cmumford/cmumford-components/src/ESP32_WROVER.FCStd

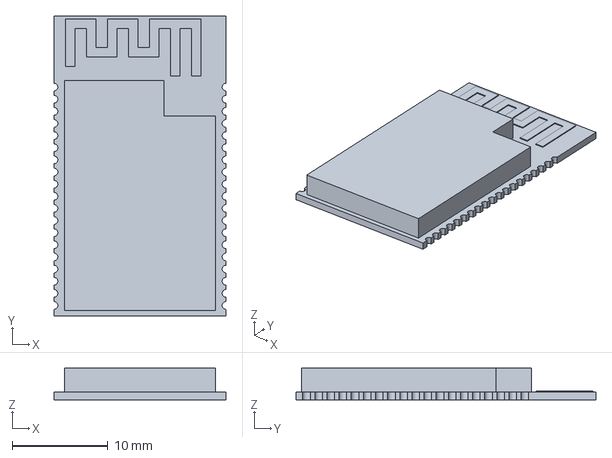
[picture p1: CAD file, 2022-02-04]
src/ESP32_WROVER.FCStd
18.0 x 31.4 x 3.30 mm
