cmumford/cmumford-components/3dshapes/PTS810SJS250SMTR LFS.STEP

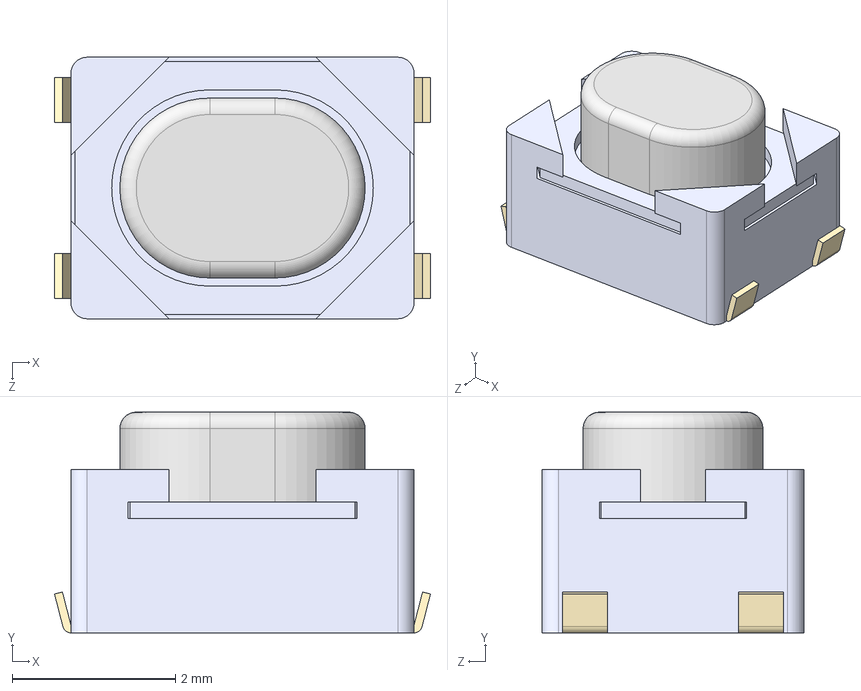
[picture p2: CAD file, 2026-04-09]
3dshapes/PTS810SJS250SMTR LFS.STEP
4.60 x 2.70 x 3.20 mm
