cmumford/cmumford-components/3dshapes/PEC12R-4225F-S0024.step

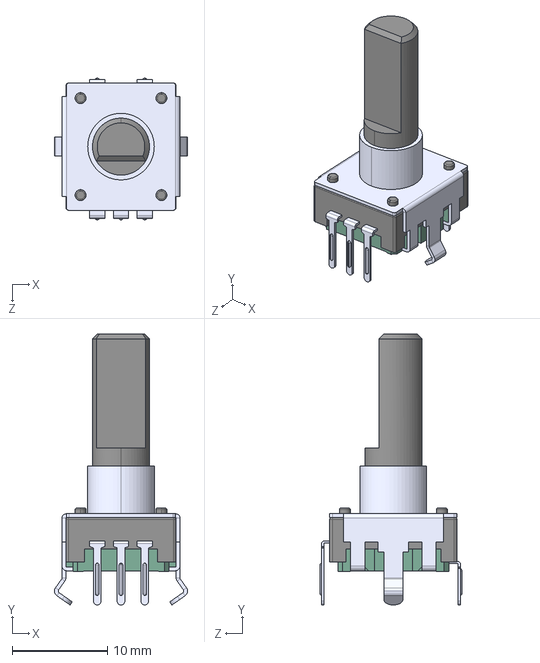
[picture p3: CAD file, 2026-04-09]
3dshapes/PEC12R-4225F-S0024.step
14.0 x 28.5 x 14.9 mm
