cmumford/cmumford-components/3dshapes/ABS07L-32.768KHZ-T.step

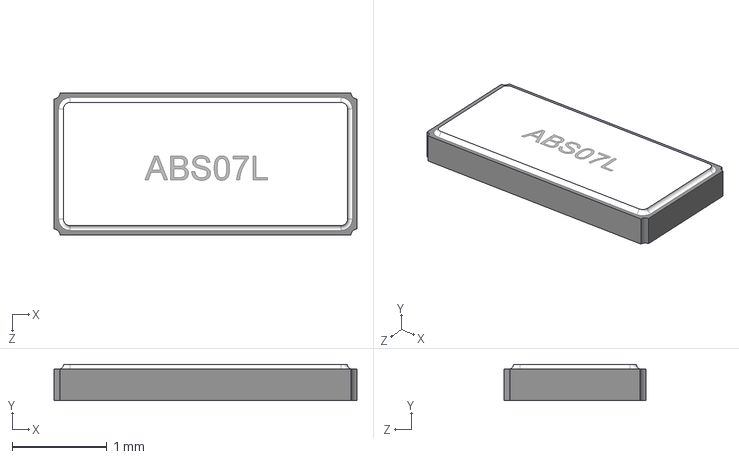
[picture p4: CAD file, 2026-04-09]
3dshapes/ABS07L-32.768KHZ-T.step
3.20 x 0.383 x 1.50 mm
