cmumford/cmumford-components/3dshapes/PTN16-A10120K1A2.step

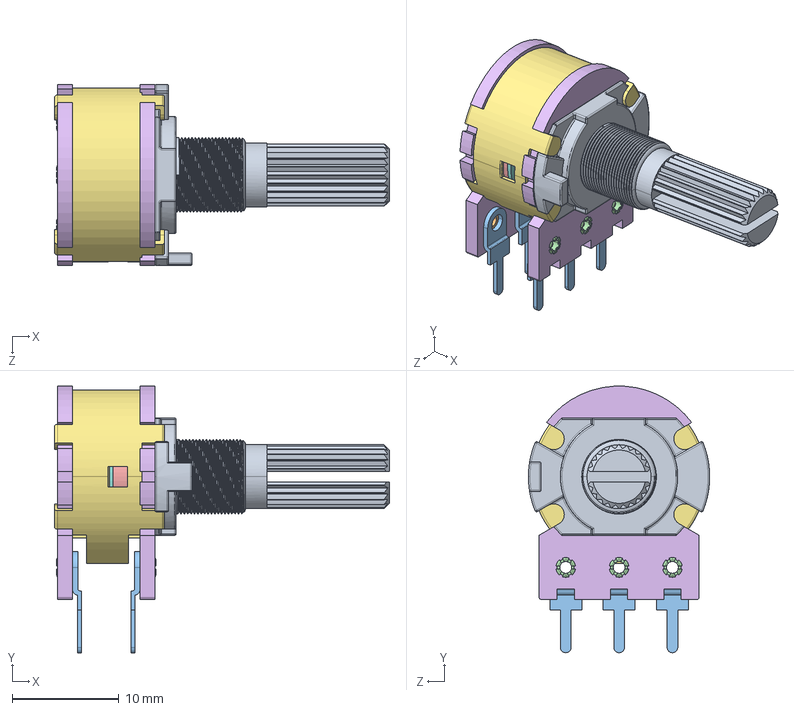
[picture p5: CAD file, 2026-04-08]
3dshapes/PTN16-A10120K1A2.step
31.4 x 25.0 x 17.0 mm
PTN16_2 BUSHING
PTN16-A_2 HOUSING
PTN16_20K1_SHAFT
