cmumford/cmumford-components/3dshapes/SJ1-3534NG.step

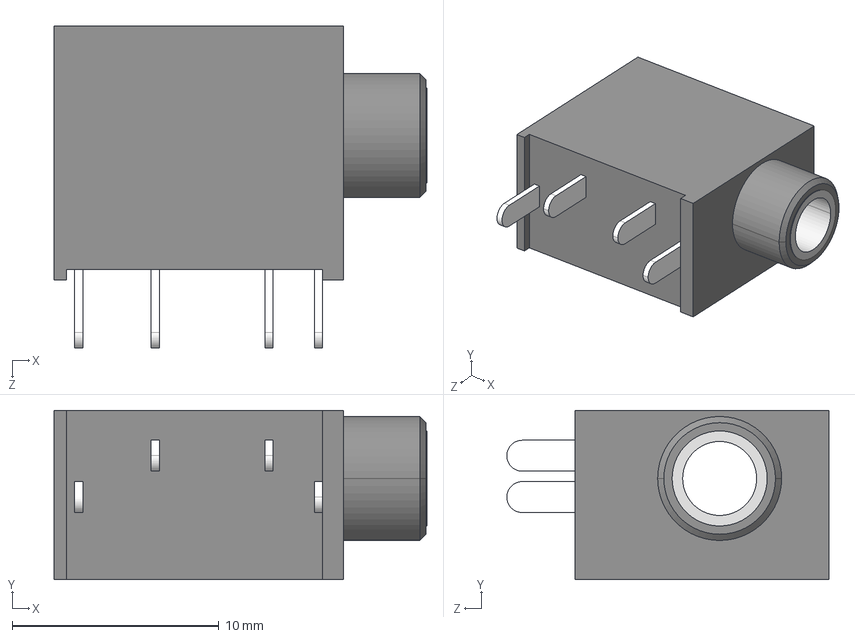
[picture p6: CAD file, 2026-04-08]
3dshapes/SJ1-3534NG.step
18.1 x 8.20 x 15.6 mm
