cmumford/cmumford-components/3dshapes/GSB343K331HR.step

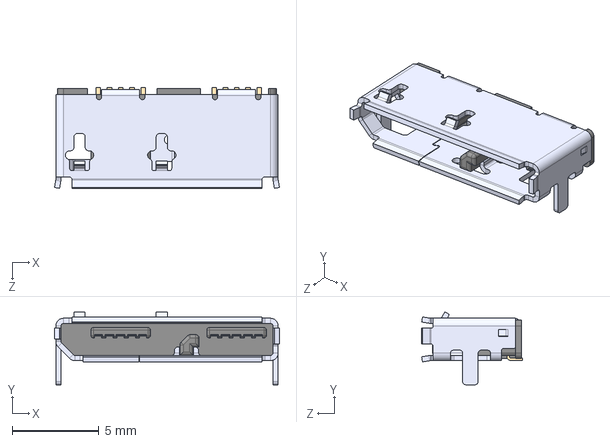
[picture p7: CAD file, 2024-02-23]
3dshapes/GSB343K331HR.step
13.0 x 4.20 x 5.82 mm
