cmumford/cmumford-components/3dshapes/usb3_ausb1-afn-btp1.stp

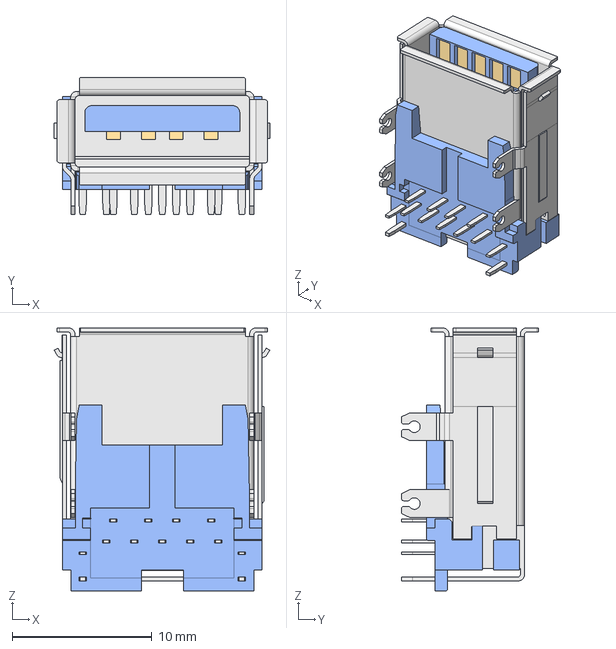
[picture p8: CAD file, 2024-02-23]
3dshapes/usb3_ausb1-afn-btp1.stp
15.4 x 9.81 x 18.8 mm
