cmumford/cmumford-components/3dshapes/RELAY_AQY_SO4_41X_PAN.step

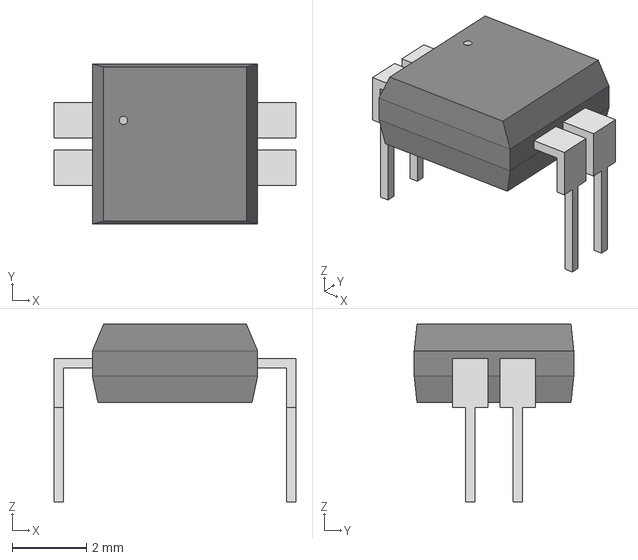
[picture p9: CAD file, 2024-02-22]
3dshapes/RELAY_AQY_SO4_41X_PAN.step
6.50 x 4.29 x 4.78 mm
