cmumford/cmumford-components/3dshapes/CUI_DEVICES_UJ2-BH-BL1-TH.step

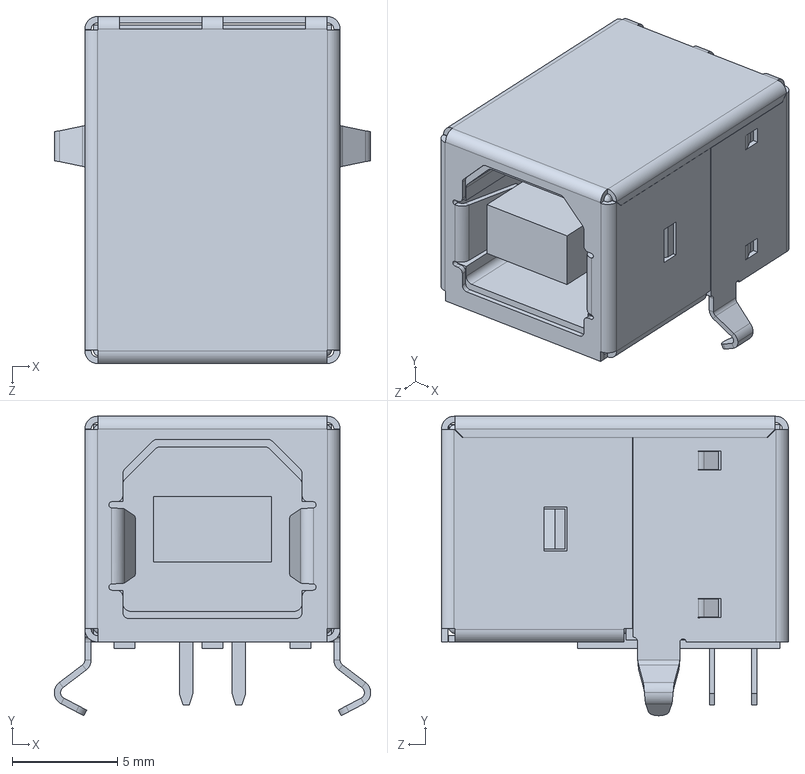
[picture p10: CAD file, 2024-02-18]
3dshapes/CUI_DEVICES_UJ2-BH-BL1-TH.step
15.0 x 14.2 x 16.5 mm
