cmumford/cmumford-components/3dshapes/SS-52400-003.step

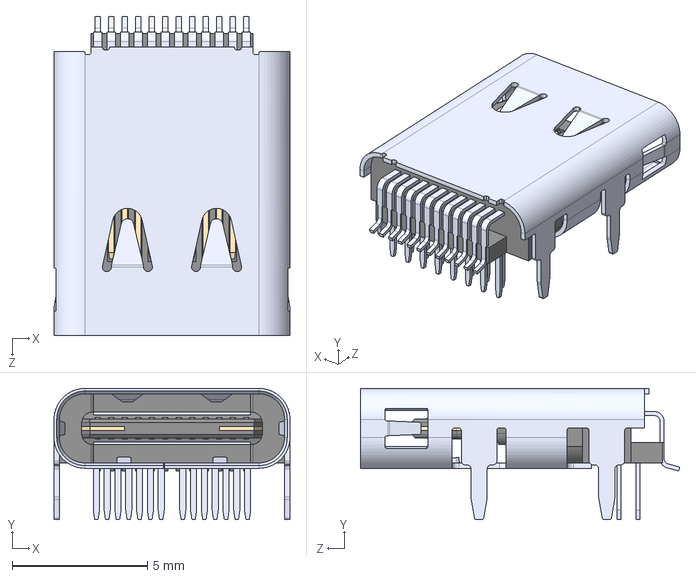
[picture p11: CAD file, 2024-02-17]
3dshapes/SS-52400-003.step
8.74 x 4.86 x 11.8 mm
