cmumford/cmumford-components/3dshapes/PJ-051AH.step

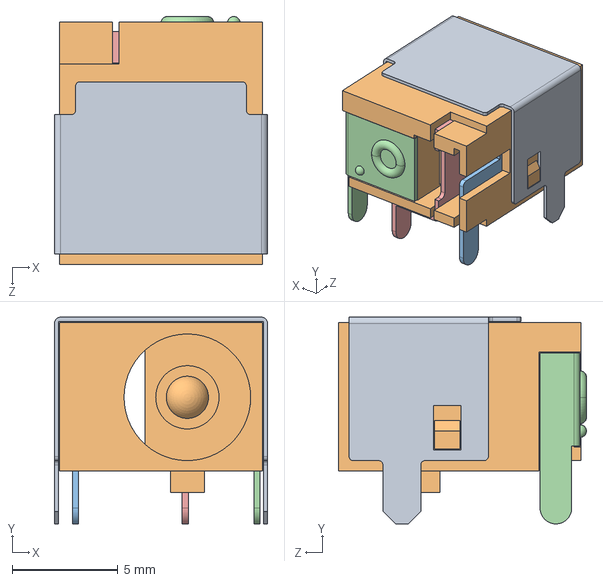
[picture p12: CAD file, 2022-09-01]
3dshapes/PJ-051AH.step
10.1 x 9.80 x 11.8 mm
