cmumford/cmumford-components/3dshapes/BK-912-TR.step

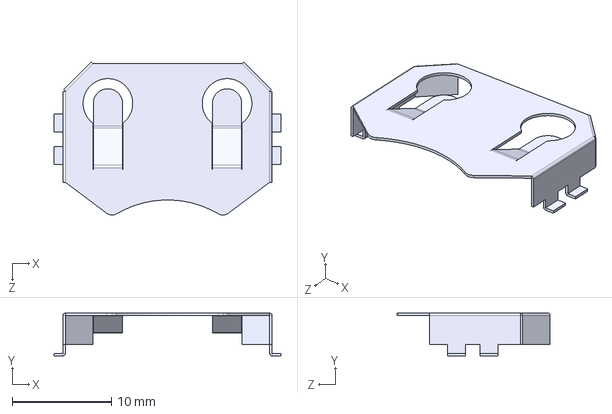
[picture p13: CAD file, 2022-08-25]
3dshapes/BK-912-TR.step
22.9 x 4.32 x 15.4 mm
