cmumford/cmumford-components/3dshapes/SHF-105-01-L-D-TH.stp

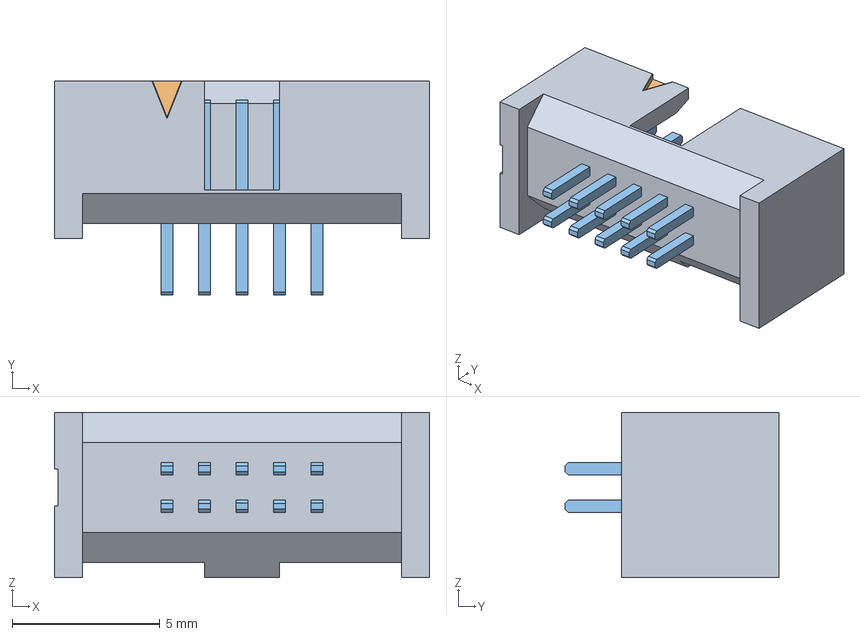
[picture p14: CAD file, 2022-01-29]
3dshapes/SHF-105-01-L-D-TH.stp
12.7 x 7.24 x 5.59 mm
_SHF-105-01-D_header
_SHF-First_Position_Indicator
_T-1S71-02-05-D-TH
