cmumford/cmumford-components/3dshapes/5034801800.step

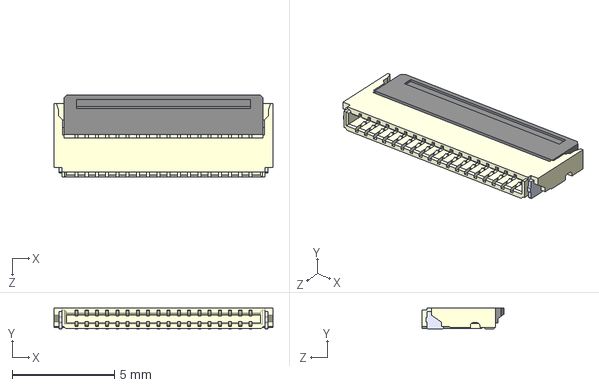
[picture p15: CAD file, 2026-04-13]
3dshapes/5034801800.step
10.7 x 1.02 x 4.00 mm
