cmumford/cmumford-components/3dshapes/2129691-1.step

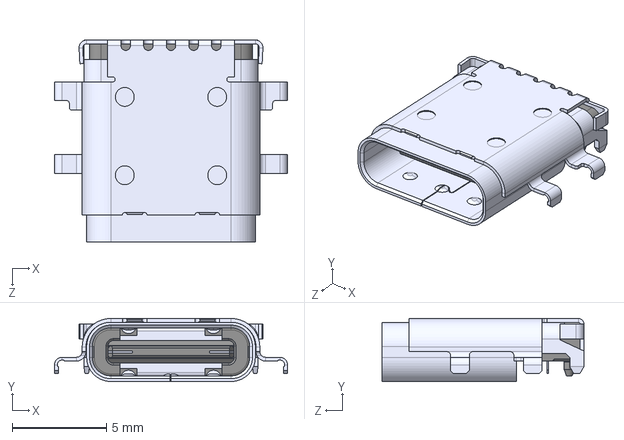
[picture p16: CAD file, 2024-02-24]
3dshapes/2129691-1.step
12.3 x 3.34 x 10.7 mm
