cmumford/cmumford-components/3dshapes/2171790001.step

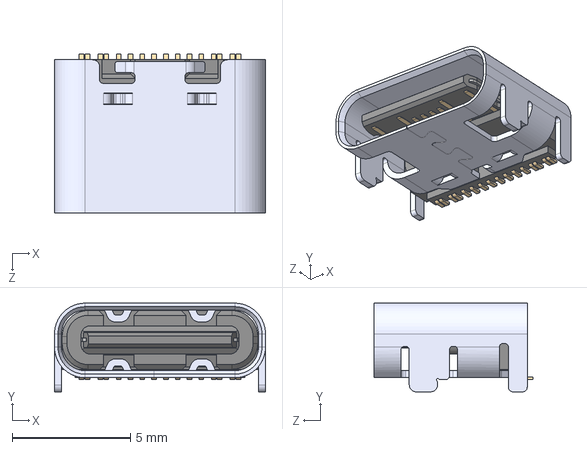
[picture p17: CAD file, 2024-02-23]
3dshapes/2171790001.step
8.94 x 3.76 x 6.75 mm
