cmumford/cmumford-components/3dshapes/484050003.stp

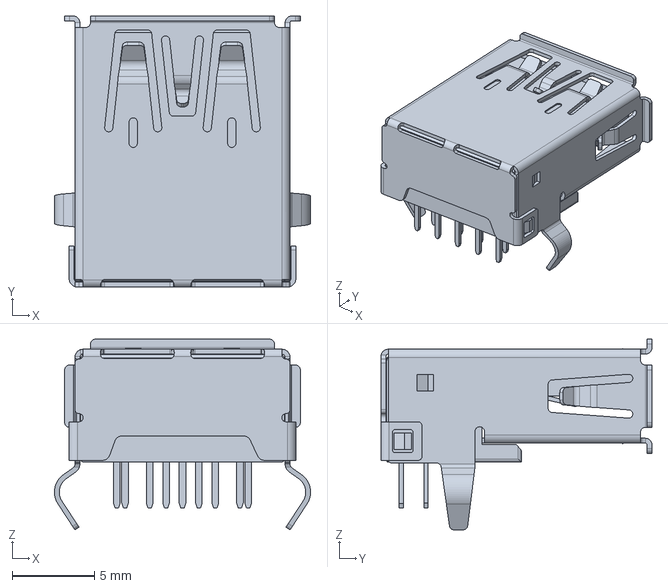
[picture p18: CAD file, 2024-02-23]
3dshapes/484050003.stp
15.6 x 16.5 x 11.6 mm
