cmumford/cmumford-components/(list of files, cad)

Other CAD files:
3dshapes/0541325062.stp
3dshapes/10118194-0001LF.step
3dshapes/1393280-5.step
3dshapes/1734510-1.step
3dshapes/s62684_501100alf.stp
