cmumford/cmumford-components/(commit log)

2022-01-29 Some sybols and footprints.
    * 0541325062
    * 3220-10-0100-00
    * 62684-50110
    * ESP32-WROOM-32E
    * LY68L6400SLIT
    * SS-52400-003
    [0541325062.stp, SHF-105-01-L-D-TH.stp]
2022-01-30 Add 62684-50110 STP file.
    Also, adjust S1/S2 pad locations, courtyard, stencil lines to
    match.
    [s62684_501100alf.stp]
2022-01-30 Add USB-C STP file.
    USB3.2 GEN2 - 12401548E412A
    Description: Right angle, Top mount dual SMT, for 1.6mm PCB
    Datasheet:
    https://cdn.amphenol-icc.com/media/wysiwyg/files/documentation/datasheet/inputoutput/io_usb_type_c.pdf
2022-02-04 Add ESP32-WROVER-E 3D file.
    [ESP32_WROVER.FCStd]
2022-08-21 symbols → library.
2022-08-21 Upgraded FeatuerS2 to KiCAD 6.
2022-08-22 Ignoring KiCAD *.bak files.
2022-08-25 Moved all footprints into a single library.
2022-08-25 Deleted old individual KiCAD v5 symbols/footprints.
    Now combined into single combined library.
2022-08-25 Pointed symbol footprints to the combined footprint library.
2022-08-25 Footprint for DS1338U-33+.
2022-08-25 Add Feather S2 silkscreen outline.
2022-08-25 Add FeatherS2 title on silkscreen.
2022-08-25 BK-912-TR component.
    https://www.digikey.com/en/products/detail/mpd-memory-protection-devices/BK-912-TR/2077831
    [BK-912-TR.step]
2022-09-01 Added PJ-051AH.
    [PJ-051AH.step]
2022-10-02 Footprint for ESP32 DEVKITV1
2022-10-02 Footprint for the ESP32 NodeMCU ESP-32S dev board.
2022-10-02 Added two ESP32 dev board symbols.
    * ESP32 NodeMCU ESP-32S
    * ESP32 DEVKITV1
2022-10-29 Increased ESP32 DEVKITV1 pin to 1/1.7
2023-01-22 Added symbol+footprint for 0.96" TFT display.
    https://www.aliexpress.us/item/2251832810664524.html
    1.Features
    SIZE 0.96inch
    Display Mode Normally black IPS
    Display Format Graphic 80RGB*160 Dot-matrix
    Input Data SPI interface
    Drive IC ST7735S
    Dimensional outline 24(W)*30 (H)*2.8+/-0.1(T)mm
    Resolution 80RGB*160 Dots
    LCD Active area 10.8 (W)*21.7 (H)
    Dot pitch 0.135(H) x 0.1356(V) mm
    Viewing Direction All View
    Operating Temperature -20～70°C
    2.Pin Descriptions:
    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
2024-02-16 Add footprint for USB4105-GF-A (USB-C 16-pin receptacle).
    https://www.digikey.com/en/products/detail/gct/USB4105-GF-A/11198441
2024-02-16 Fixed double quote that prevented KiCAD from reading
2024-02-17 Add footprint for SS-52400-003
    [SS-52400-003.step]
2024-02-18 Add 1734510-1 mini USB recepticle
    https://www.digikey.com/en/products/detail/te-connectivity-amp-connectors/1734510-1/4021669
    https://www.te.com/usa-en/product-1734510-1.datasheet.pdf
    [1734510-1.step]
2024-02-18 Add USB Micro B connector
    Amphenol 10118194-0001LF
    https://www.digikey.com/en/products/detail/amphenol-cs-fci/10118194-0001LF/2785389
    https://www.amphenol-cs.com/media/wysiwyg/files/drawing/10118194.pdf
    [10118194-0001LF.step]
2024-02-18 Add USB 2.0 TYPE-B connector: UJ2-BH-BL1-TH
    https://www.digikey.com/en/products/detail/cui-devices/UJ2-BH-BL1-TH/6188083
    https://www.cuidevices.com/product/resource/uj2-bh-th.pdf
    [CUI_DEVICES_UJ2-BH-BL1-TH.step]
2024-02-20 Add 1393280 automotive relay SPST.
    [1393280-5.step]
2024-02-22 Add RELAY_AQY_SO4_41X_PAN
    https://www.digikey.com/en/products/detail/panasonic-electric-works/AQY412SX/4757880
    [RELAY_AQY_SO4_41X_PAN.step]
2024-02-23 Add USB A 3.2 connector: AE11196-ND
    The footprint is incorrect.
    https://www.digikey.com/en/products/detail/assmann-wsw-components/AUSB1-AFN-BTP1/5253465
    https://www.assmann-wsw.com/uploads/datasheets/ASS_6770_CO.pdf
    [usb3_ausb1-afn-btp1.stp]
2024-02-23 Add USB-A 3.0 connector
    CONN RCPT USB3.0 TYPEA 9POS R/A
    USB-A (USB TYPE-A) USB 3.2 Gen 1 (USB 3.1 Gen 1, Superspeed (USB 3.0))
    Receptacle Connector 9 Position Through Hole, Right Angle
    https://www.digikey.com/en/products/detail/molex/0484050003/4701515
    https://rhu103.sma-promail.com/SQLImages/kelmscott/Molex/PDF_Images/987651-0181.PDF
    [484050003.stp]
2024-02-23 Add USB-B Micro GSB343K331HR
    USB - micro B USB 3.2 Gen 1 (USB 3.1 Gen 1, Superspeed (USB 3.0))
    Receptacle Connector 10 Position Surface Mount, Right Angle; Through Hole
    https://www.digikey.com/en/products/detail/amphenol-cs-commercial-products/GSB343K331HR/13682996
    https://cdn.amphenol-cs.com/media/wysiwyg/files/drawing/gsb343k33hr.pdf
    [GSB343K331HR.step]
2024-02-23 Add USB-C 2.0 connector: MOLEX_2171790001
    [2171790001.step]
2024-02-24 Add USB 3.1 connector: 12401598E4_2A
2024-02-24 Add USB 3.0 connector: 2129691-1
    [2129691-1.step]
2024-02-25 Add AMPHENOL_12401598E4_2A_NOEXP.kicad_mod
    The same as AMPHENOL_12401598E4_2A.kicad_mod, but with no
    mask expansion around the pads. This is to avoid design rule
    errors with JLCPCB.
2024-03-15 Add CH280QV10-CT display symbol
    https://www.adafruit.com/product/2770
    No footprint specified as different ribbon cable
    connectors (top/bottom...) may be used.
2024-03-20 Added MCP23017_REVD+_SO (fork of MCP23017_SO)
    MCP23017 REV D (and later) GPA7 and GPB7 pins are output only.
    Forking the KiCAD symbol to specify output only for error checking.
2024-03-21 Add USB-C connector: AMPHENOL_10133476-10001LF
    https://www.digikey.com/en/products/detail/amphenol-cs-fci/10133476-10001LF/7592607
2024-06-15 Reverse pin numbers of 0541325062
2024-06-24 Add ESP32-WROOM-32E-R2-INFO symbol
    This is a duplicate of KiCad's ESP32-WROOM-32E-R2
    symbol, but has input and strapping pins marked.
2026-01-07 Add TPA6111A2 symbol
    150-mW Stereo Audio Power Amplifier
2026-04-08 Set Si4703 footprint and datasheet
2026-04-08 Add SJ1-3534NG headphone jack
    [SJ1-3534NG.step]
2026-04-08 Create PTN16-A10120K1A2 based on Device:R_Potentiometer_Dual
    [PTN16-A10120K1A2.step]
2026-04-09 Add ABS07L-32.768KHZ-T crystal
    [ABS07L-32.768KHZ-T.step]
2026-04-09 Add PEC12R-4225F-S0024 encoder footprint
    [PEC12R-4225F-S0024.step]
2026-04-09 Add PTS810SJS250SMTR LFS tactile pushbutton footprint
    [PTS810SJS250SMTR LFS.STEP]
2026-04-13 Add 5034801800 FFC,FPC connector
    https://www.digikey.com/en/products/detail/molex/5034801800/2819155
    [5034801800.step]
2026-04-19 Add 765 mm telescoping FM antenna footprint
